middle-river/stm32_sdr/README.txt

http://middleriver.chagasi.com/electronics/stm32_sdr/
