middle-river/stm32_sdr/docs/schematic.pdf

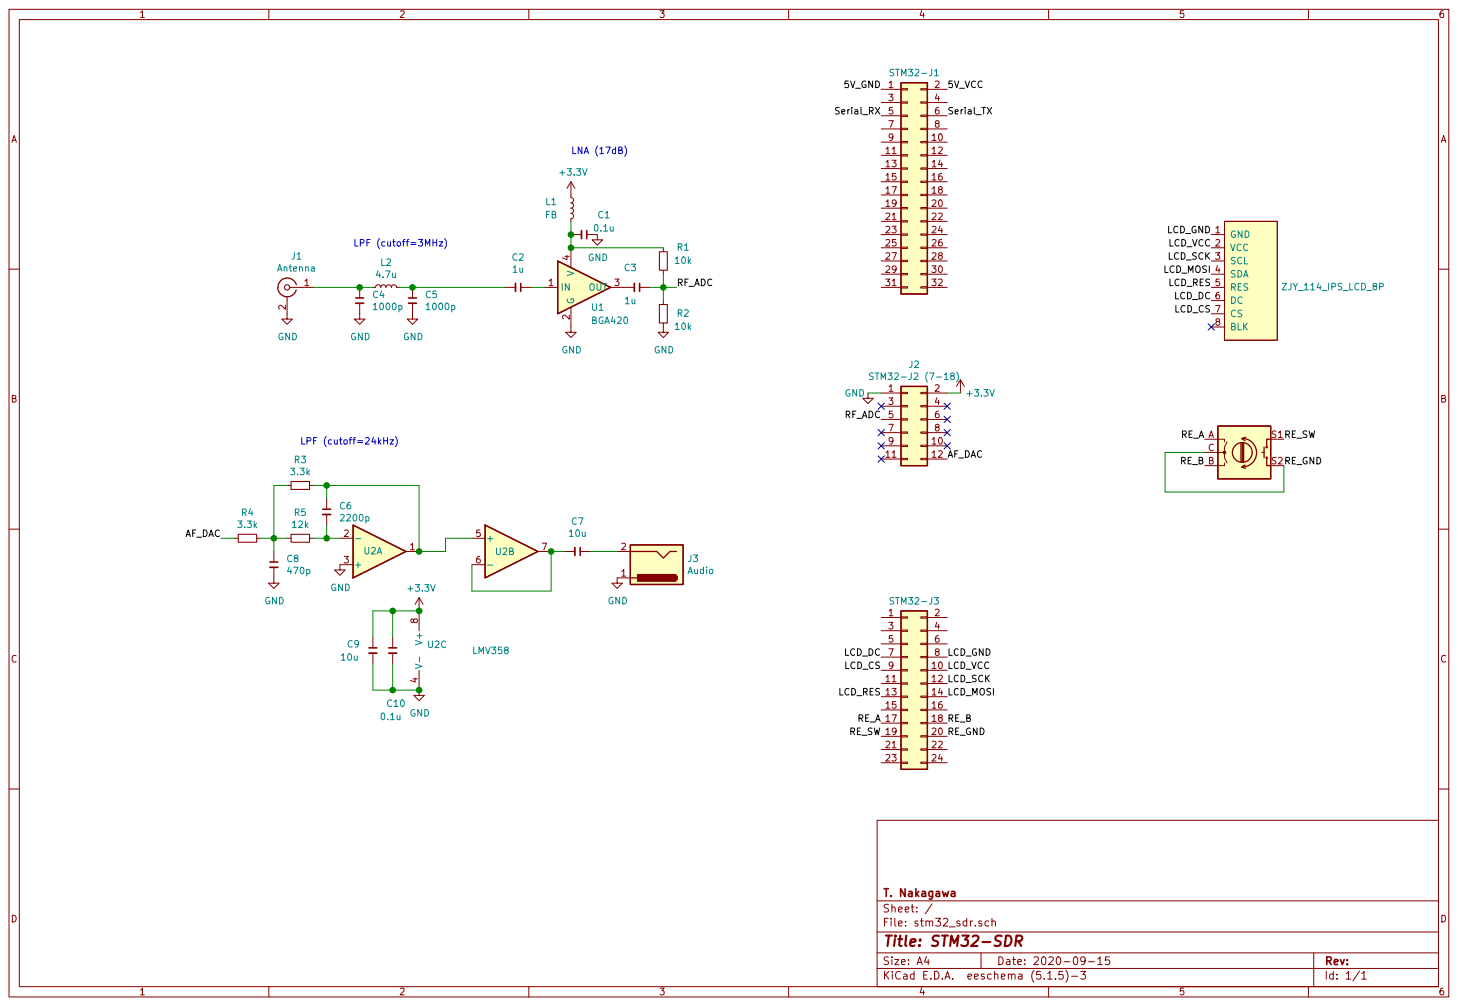
[picture p11: page 1]

File: stm32_sdr.sch Sheet: / T. Nakagawa GND
