middle-river/stm32_sdr/docs/pcb.pdf

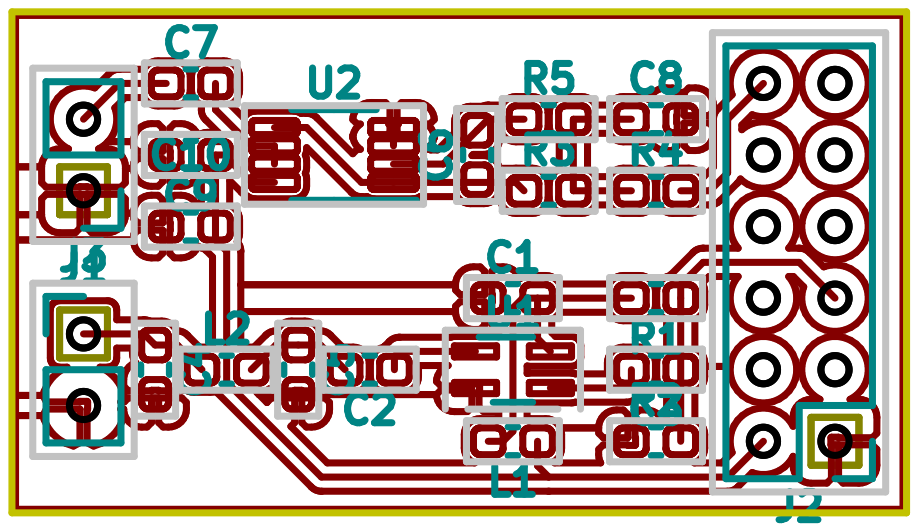
[picture p12: page 1]
