middle-river/stm32_sdr/Filter.h

/*
  Coefficients for filters.
  2020-10-04  T. Nakagawa
*/

#ifndef FILTER_H_
#define FILTER_H_

// Coefficients for decimation FIR filter with CIC compensation.
const float fir_coeff[32] = {
  -1.140811e-03f, -1.890000e-03f, -1.979986e-03f, -2.935298e-04f, +3.893323e-03f, +9.027487e-03f, +1.062969e-02f, +3.585712e-03f,
  -1.312862e-02f, -3.242807e-02f, -3.968470e-02f, -1.938192e-02f, +3.497384e-02f, +1.137517e-01f, +1.923674e-01f, +2.415355e-01f,
  +2.415355e-01f, +1.923674e-01f, +1.137517e-01f, +3.497384e-02f, -1.938192e-02f, -3.968470e-02f, -3.242807e-02f, -1.312862e-02f,
  +3.585712e-03f, +1.062969e-02f, +9.027487e-03f, +3.893323e-03f, -2.935298e-04f, -1.979986e-03f, -1.890000e-03f, -1.140811e-03f,
};

// Coefficients for low-pass IIR filters.
const float iir_coeff[7][6] = {
  {+1.763180e-04f, +3.526359e-04f, +1.763180e-04f, +1.000000e+00f, -1.962092e+00f, +9.627971e-01f},
  {+1.071768e-03f, +2.143535e-03f, +1.071768e-03f, +1.000000e+00f, -1.905285e+00f, +9.095717e-01f},
  {+4.097811e-03f, +8.195621e-03f, +4.097811e-03f, +1.000000e+00f, -1.810931e+00f, +8.273219e-01f},
  {+1.504229e-02f, +3.008458e-02f, +1.504229e-02f, +1.000000e+00f, -1.624324e+00f, +6.844934e-01f},
  {+7.514726e-02f, +1.502945e-01f, +7.514726e-02f, +1.000000e+00f, -1.089055e+00f, +3.896437e-01f},
  {+2.285116e-01f, +4.570232e-01f, +2.285116e-01f, +1.000000e+00f, -2.704899e-01f, +1.845364e-01f},
  {+7.211295e-01f, +1.442259e+00f, +7.211295e-01f, +1.000000e+00f, +1.362916e+00f, +5.216015e-01f},
};
const int lpf[7] = {200, 500, 1000, 2000, 5000, 10000, 20000};

// Coefficients for Hilbert FIR filter.
const float hlb_coeff[31] = {
  +2.050168e-02f, -8.936550e-06f, +2.134400e-02f, -1.525098e-05f, +3.265204e-02f, -1.994669e-05f, +4.875590e-02f, -5.669759e-06f,
  +7.296282e-02f, -6.837180e-06f, +1.139842e-01f, -2.125425e-05f, +2.040173e-01f, -4.591766e-06f, +6.338458e-01f, +0.000000e+00f,
  -6.338458e-01f, +4.591766e-06f, -2.040173e-01f, +2.125425e-05f, -1.139842e-01f, +6.837180e-06f, -7.296282e-02f, +5.669759e-06f,
  -4.875590e-02f, +1.994669e-05f, -3.265204e-02f, +1.525098e-05f, -2.134400e-02f, +8.936550e-06f, -2.050168e-02f,
};

#endif
